StormWulf/Mobile-Motion-Tracking-Robot-Arm/Documents/Presentation/Poster/poster_example.jpg

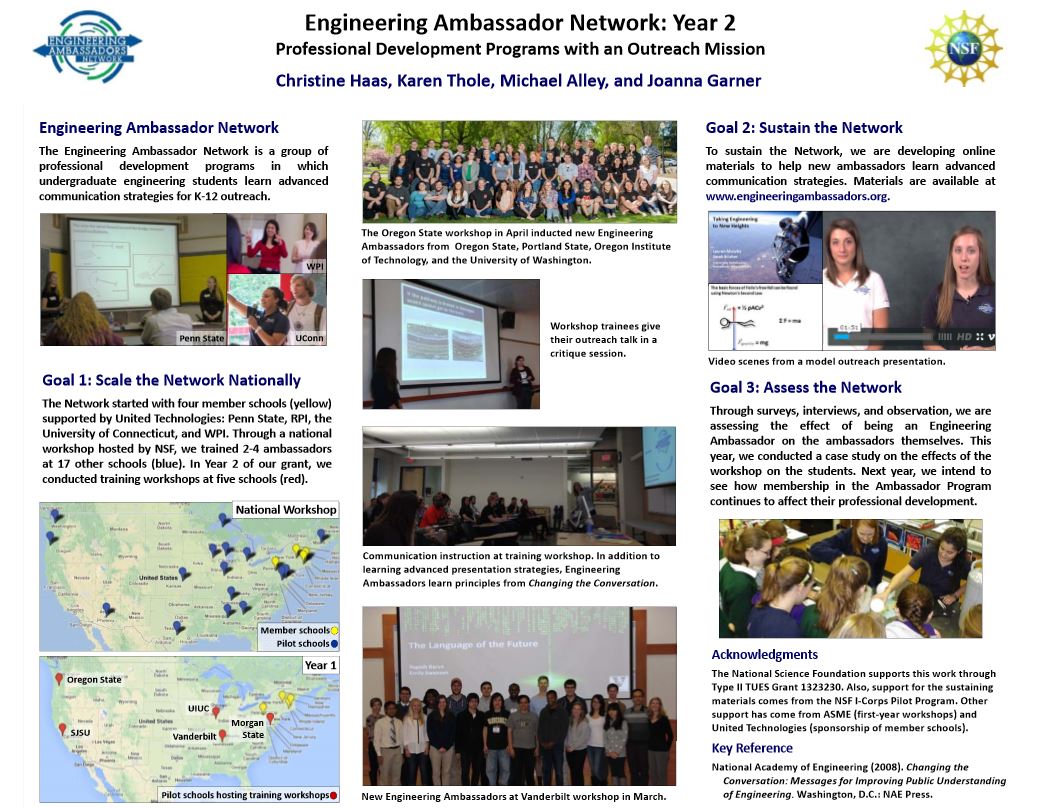
Documents/Presentation/Poster/poster_example.jpg
