StormWulf/Mobile-Motion-Tracking-Robot-Arm/Robot arm/RobotArmTasksList.md

#Robot Arm Task List
- [ ] Try using NewSoftwareSerial instead of SoftwareSerial
