StormWulf/Mobile-Motion-Tracking-Robot-Arm/Documents/Report/Outline.docx

# 1.0 Introduction

# 2.0 Project Definition

## 2.1 Patent Search

# 3.0 Evaluation of Alternatives

# 4.0 Design Approach

## 4.1 Robotic arm

## 4.2 Arduino

## 4.3 Kinect

## 4.4 Platform

# 5.0 Design Narrative

## 5.1 Robotic arm

## 5.2 Kinect

## 5.3 Arduino

## 5.4 Platform

# 6.0 Professional and Societal Concerns, Cost and Economic Evaluation

# 7.0 Discussion

# 8.0 Conclusion and Recommendations

## 8.1 Robotic arm

## 8.2 Kinect

## 8.3 Arduino

## 8.4 Platform

# 9.0 References

# 10. Appendices
