StormWulf/Mobile-Motion-Tracking-Robot-Arm/Documents/Proposal/Mid-term Presentation draft.docx

XBee Wireless Module

For sending wireless communication from the PC to the microcontroller, we are using a radio frequency module called XBee, a brand name model created by Digi International. There are a vast number of modules in the XBee, though for this project, we have chosen XBee 802.15.4. The XBee brand is desirable because it uses radio frequency rather than a Wi-Fi signal, as it proves more versatile in areas where Wi-Fi in unavailable, such as in rural areas. The XBee 802.15.4 itself stands out from the rest of the XBee family because it is the most compatible with our microcontroller, which will be responsible for executing movements to the robot arm and platform.
