StormWulf/Mobile-Motion-Tracking-Robot-Arm/Documents/Fall 15/lecture 3/IMG_0668.JPG

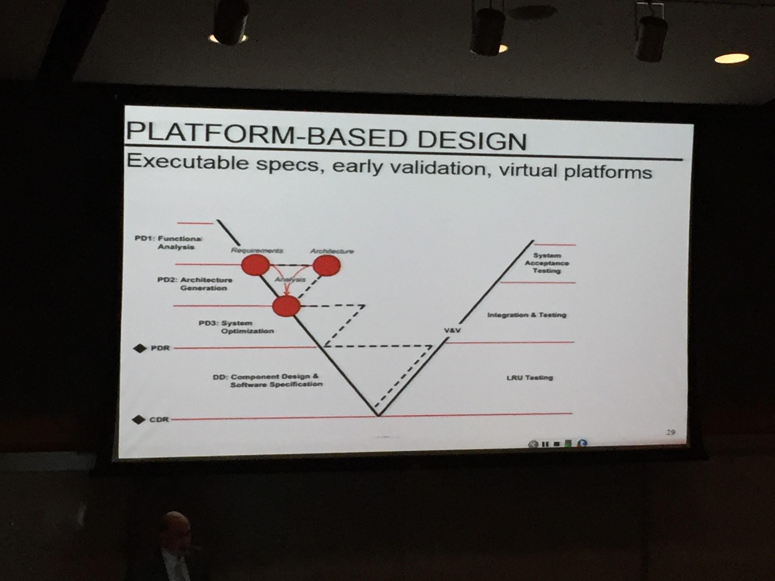
Documents/Fall 15/lecture 3/IMG_0668.JPG
