StormWulf/Mobile-Motion-Tracking-Robot-Arm/Documents/Fall 15/Lecture 4/Photo Nov 03, 6 29 51 PM.jpg

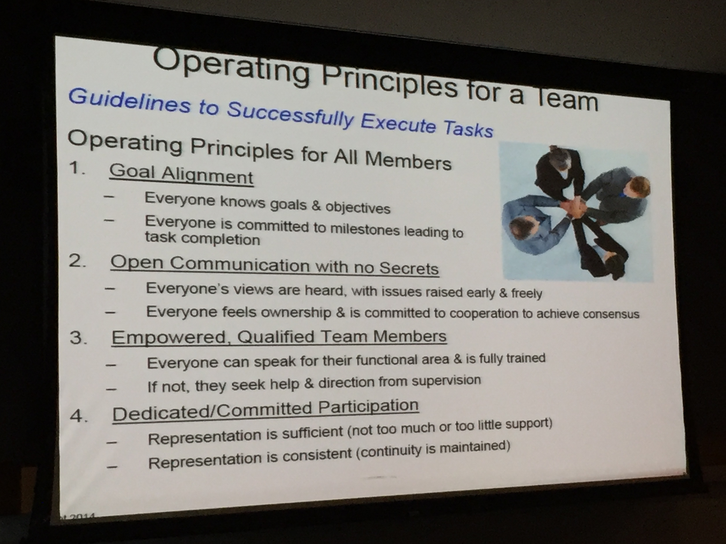
Documents/Fall 15/Lecture 4/Photo Nov 03, 6 29 51 PM.jpg
