StormWulf/Mobile-Motion-Tracking-Robot-Arm/Robot arm/SSC-32 initial position.png

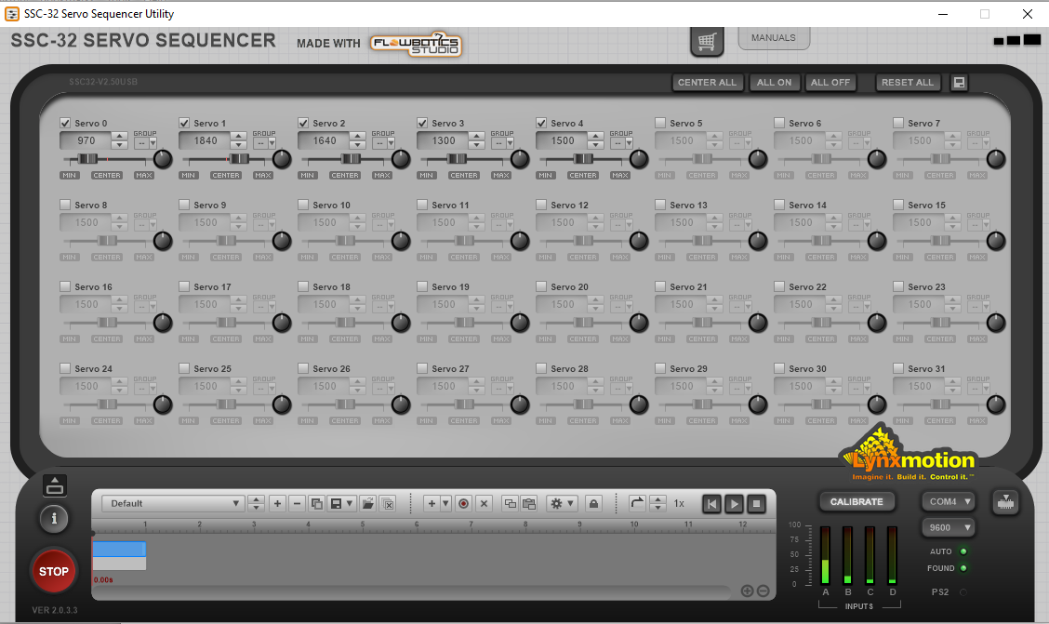
Robot arm/SSC-32 initial position.png
