StormWulf/Mobile-Motion-Tracking-Robot-Arm/(threads)

Thread 1 (2016-03-10):

Opening/Closing of gripper using gestures

StormWulf, 2016-03-10:
Figure how to configure the Kinect code to recognize hand gestures for controlling the gripper

StormWulf, 2016-03-31:
Closed hand servo position `2280`

Opened hand position `1500`

jruocco36, 2016-04-03:
Can now control the gripper using Kinect gestures.  With palm facing the Kinect, an open hand will open the gripper, while a closed hand will close the gripper.

Closed 2016-04-03.

Thread 2 (2016-03-10):

Xbee Wiress Module

StormWulf, 2016-03-10:
Connect the Arduino to the SSC-32 wirelessly with the Xbee module rather than wired

StormWulf, 2016-03-22:
Need to figure out how to properly communicate the Xbee modules

StormWulf, 2016-03-23:
https://learn.sparkfun.com/tutorials/xbee-shield-hookup-guide/example-communication-test

jruocco36, 2016-03-24:
I think we need to configure the xbee modules to talk to each other.  I found a video that might help us.
https://www.youtube.com/watch?v=rk5QpzgHXGM

StormWulf, 2016-03-24:
This might be helpful
https://github.com/andrewrapp/xbee-arduino

jruocco36, 2016-03-28:
http://forum.arduino.cc/index.php?topic=15718.0

This thread should help us solve our problem.  Basically the xbee header uses the same RX/TX pins as the usb, so they can't be used at the same time.  We have to use software serial to send the servo instructions that the Arduino sends to different pins on the Arduino and then wire those pins to the RX/TX pins on the xbee separately.  Tomorrow I'll look into how to wire the xbee and arduino without using the header and we can try to get it wokring when we meet.

Closed 2016-03-29.

Thread 6 (2016-03-29):

Mobile platform

StormWulf, 2016-03-29:
We need to be able to control the platform wheel servos via the keyboard

StormWulf, 2016-03-31:
At position `1505` : wheel is paused

At a position of above `1505` : wheel moves forward

At a position of below `1505` : wheel moves backward

For now, our ideal servo position will be `1460`

StormWulf, 2016-03-31:
https://drive.google.com/folderview?id=0B0RCKYn34peHSTZLT08zd21PTUE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

jruocco36, 2016-04-03:
Movement is possible but needs heavy refinement

Closed 2016-05-11.
