StormWulf/Mobile-Motion-Tracking-Robot-Arm/(commit log)

2016-03-08 Initial commit from Dropbox
    [Coordinates.ods]
2016-03-10 new coordinates
    [Coordinates.ods]
2016-03-10 Fix initial position and force grip to stick
    [ArmControl.ino]
2016-03-29 Switch to SoftwareSerial for Xbees
2016-03-29 updates for smoother arm movement
    [Coordinates.ods, Coordinates.xlsx]
2016-03-31 adjusted values for more controlled movement
    [Coordinates.xlsx]
2016-03-31 arduino receive gesture
2016-04-02 platform control
    [Coordinates.xlsx]
2016-04-03 gripper control
    [Coordinates.xlsx]
2016-04-05 calculations for inverse kinematics
    [inversek.xls]
2016-04-05 applying IK to arm movement
2016-04-12 ik testing
    [inversek.xls]
2016-04-12 inverse kinematic tweaks
    [inversek.xls]
2016-04-12 IK updates
    [inversek.xls]
2016-04-21 Sample poster
2016-04-26 Try millis() for wrist
2016-04-28 update costs
    [Costs.xlsx]
2016-05-03 range updates
    [Coordinates.xlsx, inversek.xls]
2016-05-03 IK fixes
    IK calculation fixes and automatic wrist movement (wrist will keep a
    specific angle to ground)
    [ArmControl_IK.ino]
